muhardianab/STM32_Bluepill_Board/README.md

# STM32_Bluepill_Board
ReDesign STM32 Bluepill Board

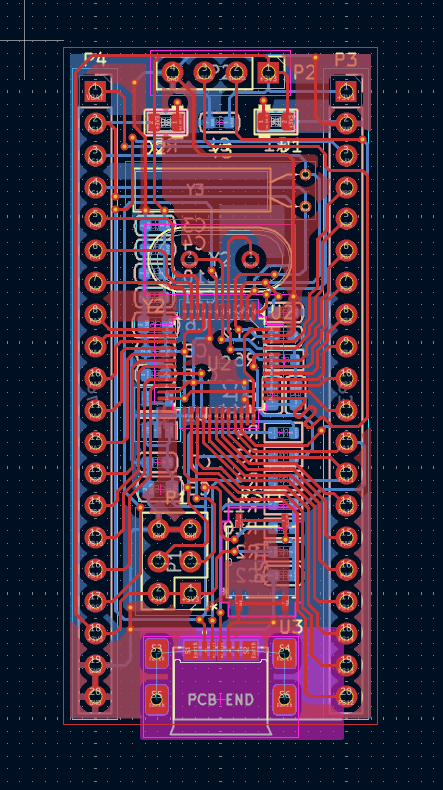
[picture p1: STM32_Bluepill_Kicad/board_layer_all.png]
PCB_preview


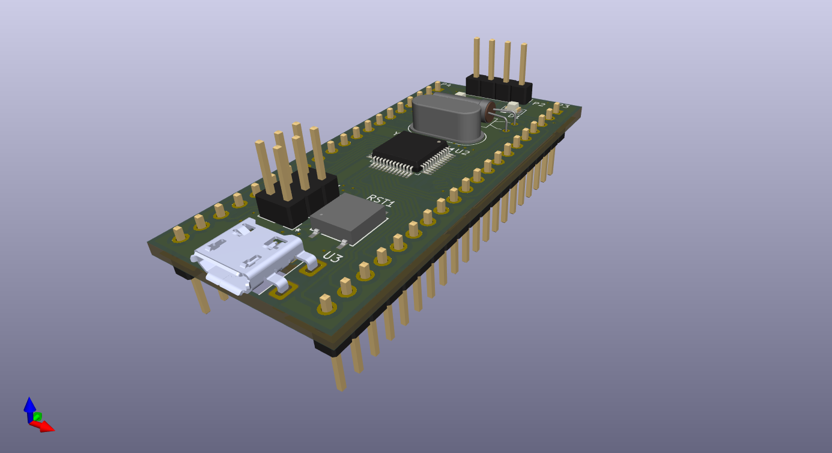
[picture p2: STM32_Bluepill_Kicad/SMT32_Bluepill_IsometricView.png]
Board


You can find the 3D file preview on [Grabcad](https://grabcad.com/library/stm32_bluepill-1)
