muhardianab/STM32_Bluepill_Board/STM32_Bluepill_Kicad/board_layer_top.png

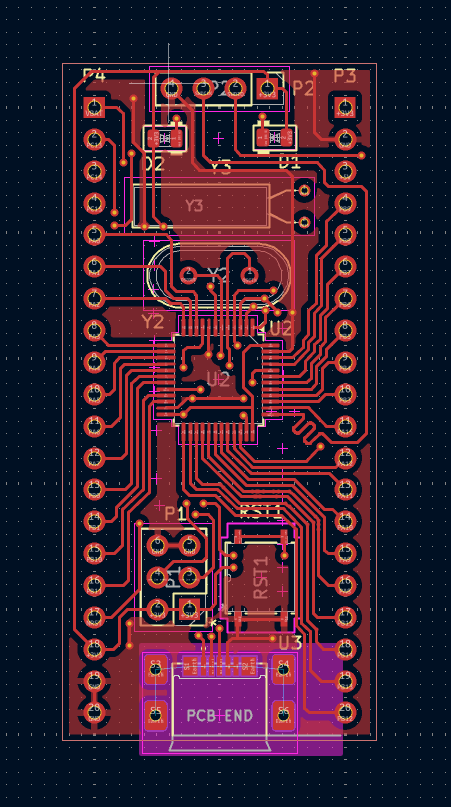
STM32_Bluepill_Kicad/board_layer_top.png
