muhardianab/STM32_Bluepill_Board/STM32_Bluepill_Kicad/SMT32_Bluepill_BottomView.png

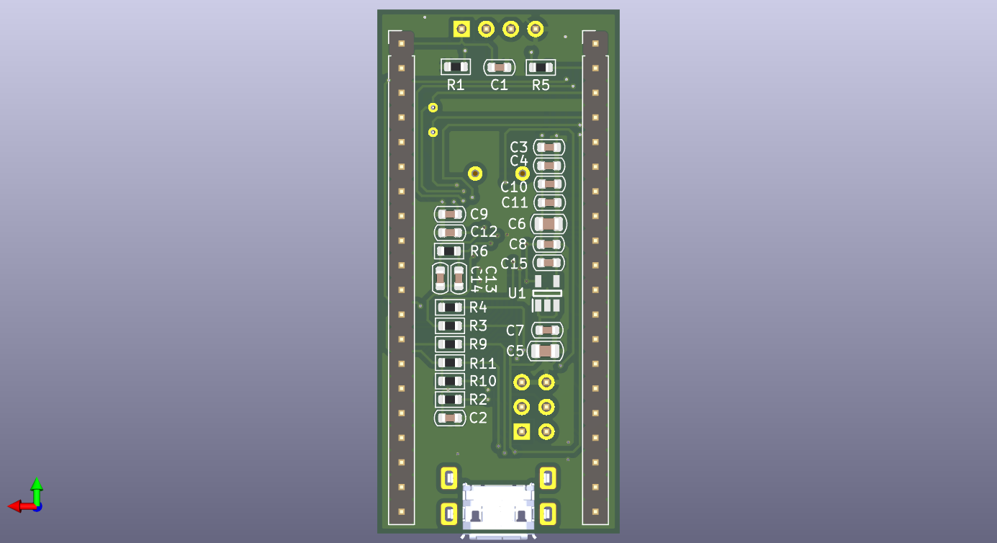
STM32_Bluepill_Kicad/SMT32_Bluepill_BottomView.png
