muhardianab/STM32_Bluepill_Board/STM32_Bluepill_Kicad/SMT32_Bluepill_IsometricBottomView.png

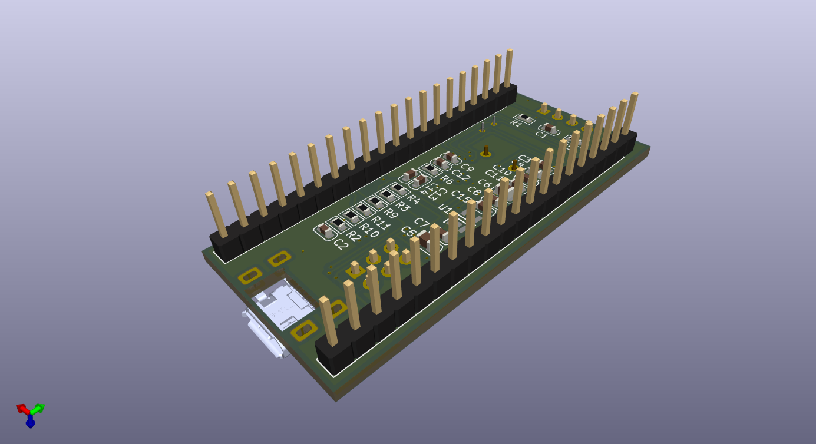
STM32_Bluepill_Kicad/SMT32_Bluepill_IsometricBottomView.png
