muhardianab/STM32_Bluepill_Board/STM32_Bluepill_Kicad/SMT32_Bluepill.step

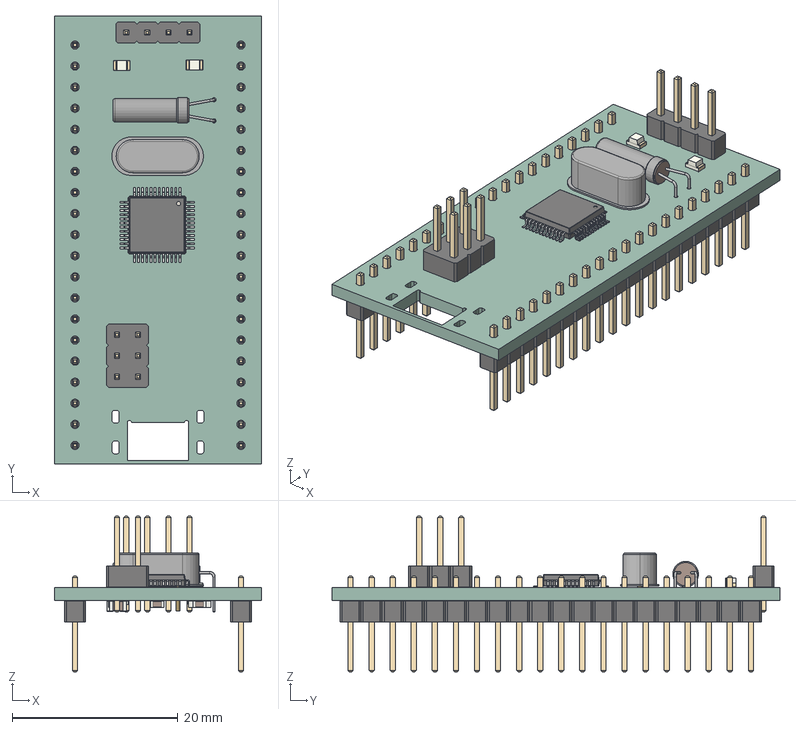
[picture p7: CAD file, 2025-02-28]
STM32_Bluepill_Kicad/SMT32_Bluepill.step
25.0 x 54.0 x 18.8 mm
LQFP-48_7x7mm_P0.5mm
LED_0805_2012Metric x 2
Crystal_AT310_D3.0mm_L10.0mm_Horizontal
Crystal_HC49-4H_Vertical
PinHeader_2x03_P2.54mm_Vertical
PinHeader_1x04_P2.54mm_Vertical
R_0603_1608Metric x 9
PinHeader_1x20_P2.54mm_Vertical x 2
C_0805_2012Metric x 2
C_0603_1608Metric x 13
SMT32_Bluepill_PCB
