muhardianab/STM32_Bluepill_Board/STM32_Bluepill_Kicad/SMT32_Bluepill.pdf

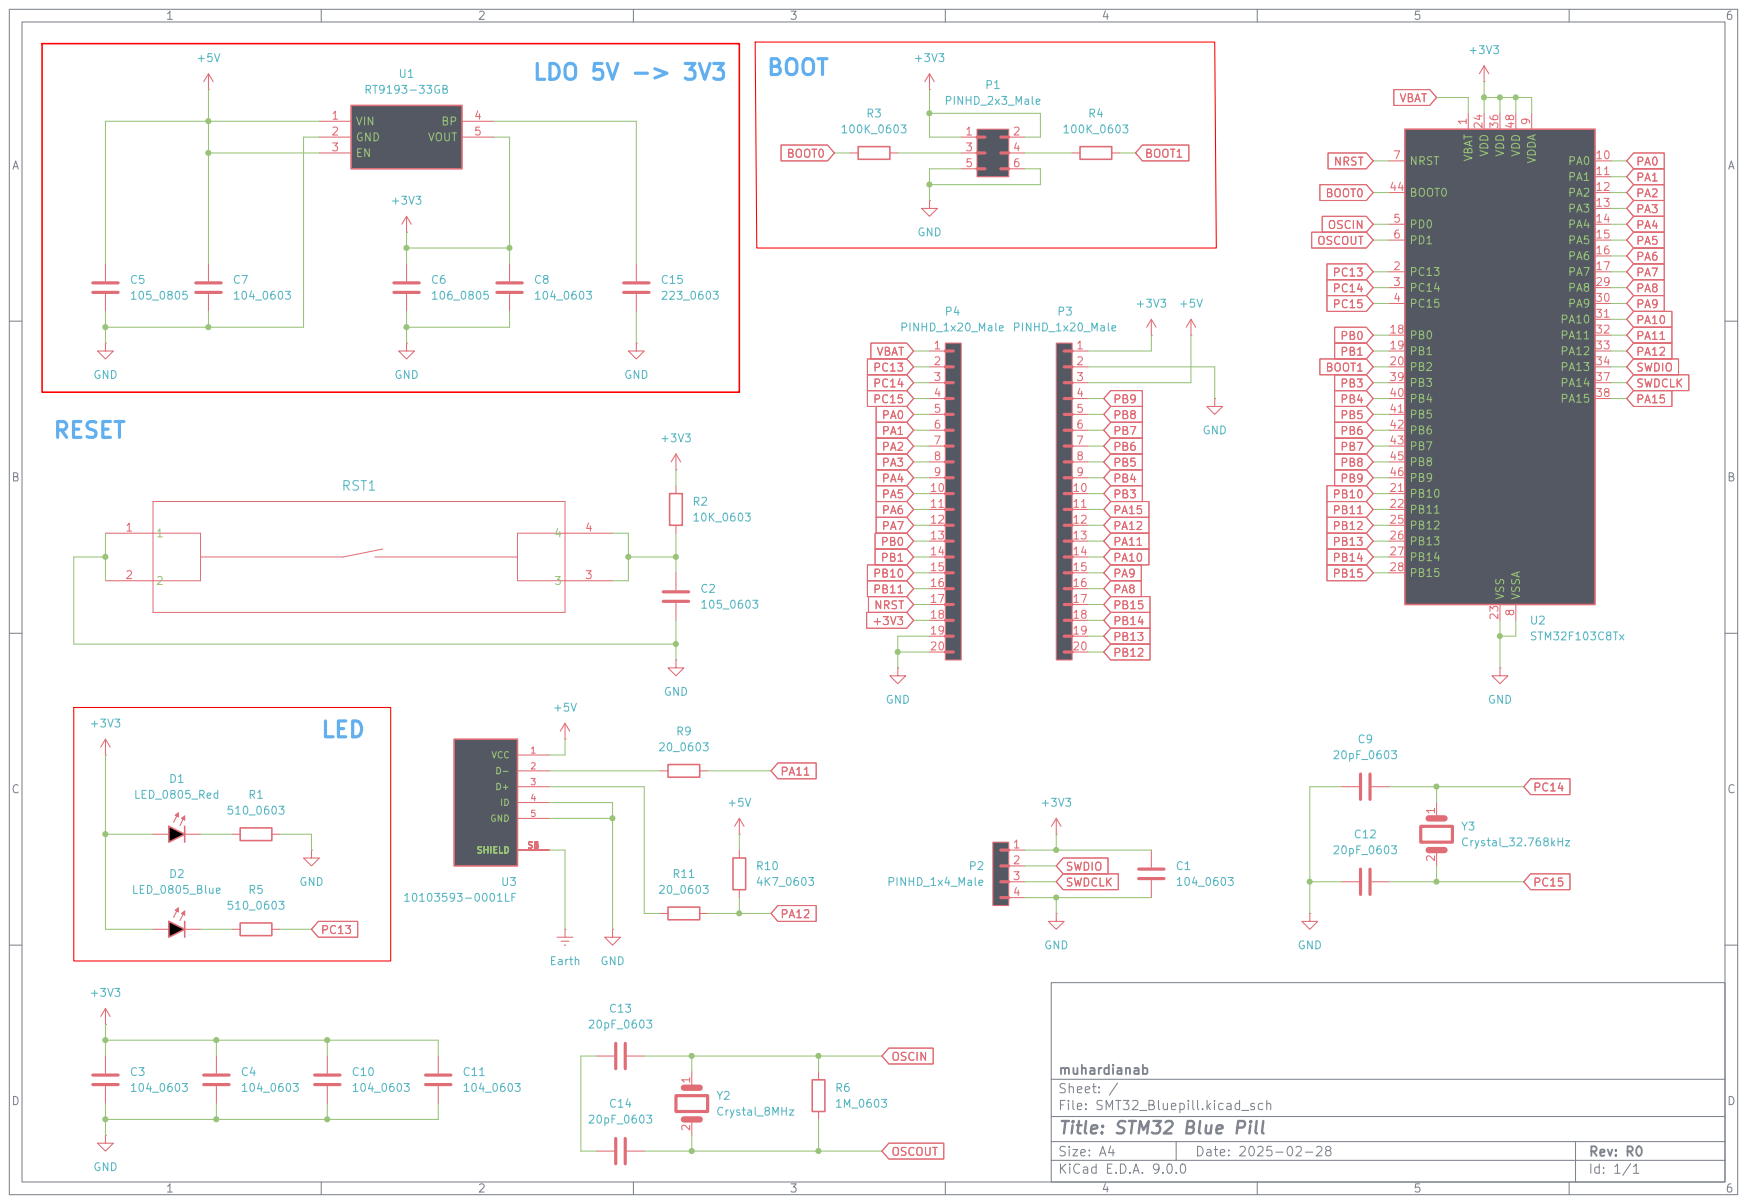
[picture p8: page 1]
