muhardianab/STM32_Bluepill_Board/STM32_Bluepill_Kicad/SMT32_Bluepill.kicad_pcb

## KiCad design STM32_Bluepill_Kicad/SMT32_Bluepill.kicad_pcb (2025-09-29)

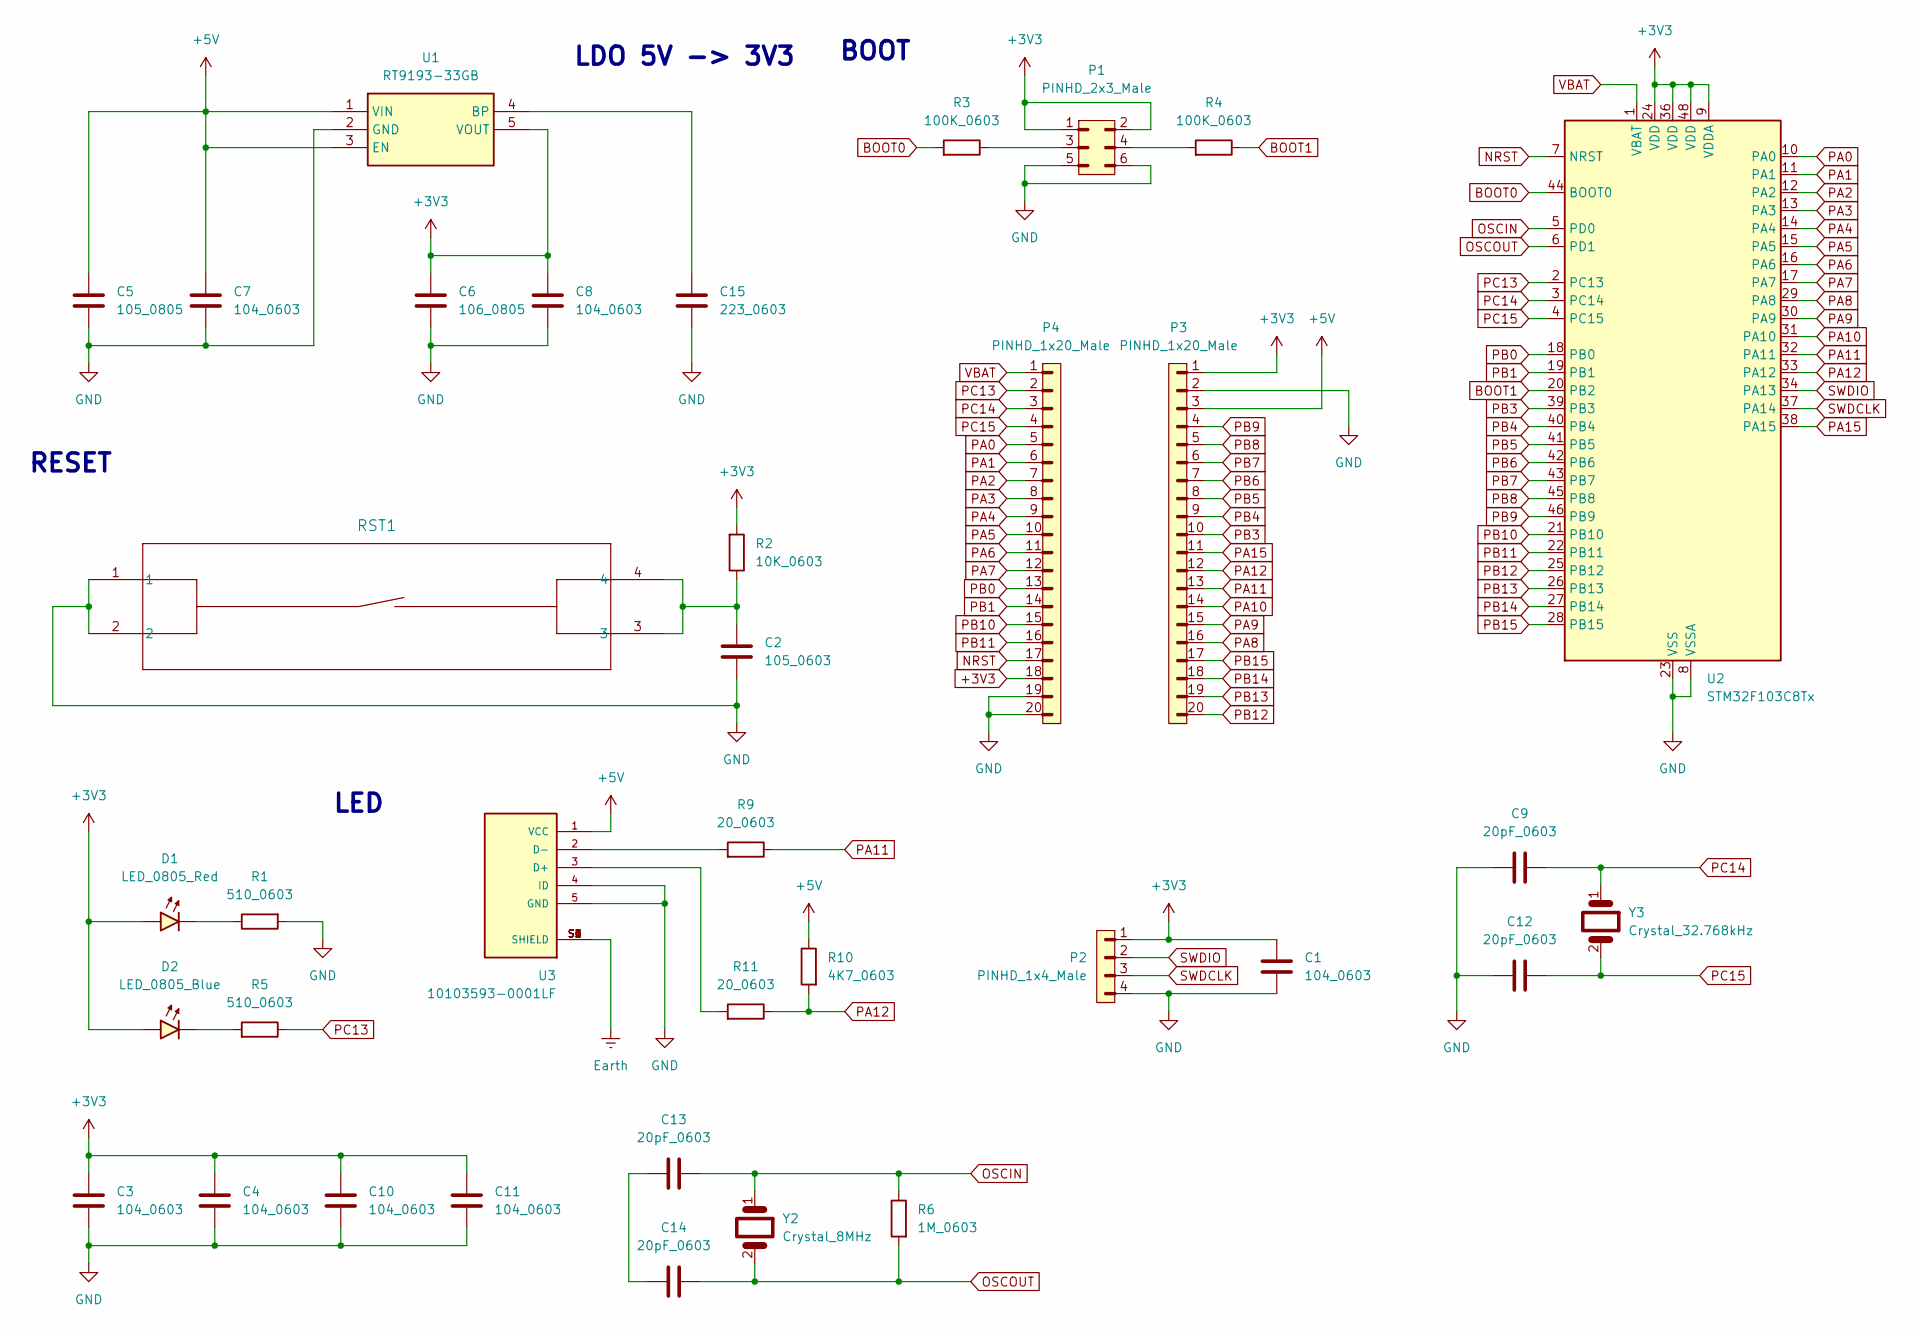
[picture p9: schematic SMT32_Bluepill.kicad_sch, STM32 Blue Pill]

Parts:
C1, C3, C4, C7, C8, C10, C11: 104_0603; C_0603_1608Metric
C2: 105_0603; C_0603_1608Metric
C5: 105_0805; C_0805_2012Metric
C6: 106_0805; C_0805_2012Metric
C9, C12, C13, C14: 20pF_0603; C_0603_1608Metric
C15: 223_0603; C_0603_1608Metric
D1: LED_0805_Red; LED_0805_2012Metric
D2: LED_0805_Blue; LED_0805_2012Metric
P1: PINHD_2x3_Male; PinHeader_2x03_P2.54mm_Vertical
P2: PINHD_1x4_Male; PinHeader_1x04_P2.54mm_Vertical
P3, P4: PINHD_1x20_Male; PinHeader_1x20_P2.54mm_Vertical
R1, R5: 510_0603; R_0603_1608Metric
R2: 10K_0603; R_0603_1608Metric
R3, R4: 100K_0603; R_0603_1608Metric
R6: 1M_0603; R_0603_1608Metric
R9, R11: 20_0603; R_0603_1608Metric
R10: 4K7_0603; R_0603_1608Metric
RST1: PTS526 SM15 SMTR2 LFS; SON4_PTS526 SM15 SMTR2 LFS_CNK-M
U1: RT9193-33GB; SOT94P279X130-5N; Mouser Part Number 835-RT9193-33GB
U2: STM32F103C8Tx; LQFP-48_7x7mm_P0.5mm
U3: 10103593-0001LF; AMPHENOL_10103593-0001LF; PARTREV A
Y2: Crystal_8MHz; Crystal_HC49-4H_Vertical
Y3: Crystal_32.768kHz; Crystal_AT310_D3.0mm_L10.0mm_Horizontal

Connections:
+3V3: C1.1, C3.1, C4.1, C6.1, C8.1, C10.1, C11.1, D1.2 (A), D2.2 (A), P1.1, P1.2, P2.1, P3.1, P4.18, R2.1, U1.5 (VOUT), U2.9 (VDDA), U2.24 (VDD), U2.36 (VDD), U2.48 (VDD)
+5V: C5.1, C7.1, P3.3, R10.2, U1.1 (VIN), U1.3 (EN), U3.1 (VCC)
BOOT0: R3.1, U2.44 (BOOT0)
BOOT1: R4.2, U2.20 (PB2)
Earth: U3.S1 (SHIELD), U3.S2 (SHIELD), U3.S3 (SHIELD), U3.S4 (SHIELD), U3.S5 (SHIELD), U3.S6 (SHIELD)
GND: C1.2, C2.2, C3.2, C4.2, C5.2, C6.2, C7.2, C8.2, C9.1, C10.2, C11.2, C12.1, C15.2, P1.5, P1.6, P2.4, P3.2, P4.19, P4.20, R1.1, RST1.1, RST1.2, U1.2 (GND), U2.8 (VSSA), U2.23 (VSS), U2.35 (VSS), U2.47 (VSS), U3.4 (ID), U3.5 (GND)
NRST: P4.17, U2.7 (NRST)
unnamed: C2.1, R2.2, RST1.3, RST1.4
unnamed: C13.1, C14.1
unnamed: D1.1 (K), R1.2
unnamed: D2.1 (K), R5.1
unnamed: P1.3, R3.2
unnamed: P1.4, R4.1
unnamed: C15.1, U1.4 (BP)
unnamed: R11.1, U3.3 (D+)
unnamed: R9.1, U3.2 (D-)
OSCIN: C13.2, R6.2, U2.5 (PD0), Y2.1
OSCOUT: C14.2, R6.1, U2.6 (PD1), Y2.2
PA0: P4.5, U2.10 (PA0)
PA1: P4.6, U2.11 (PA1)
PA2: P4.7, U2.12 (PA2)
PA3: P4.8, U2.13 (PA3)
PA4: P4.9, U2.14 (PA4)
PA5: P4.10, U2.15 (PA5)
PA6: P4.11, U2.16 (PA6)
PA7: P4.12, U2.17 (PA7)
PA8: P3.16, U2.29 (PA8)
PA9: P3.15, U2.30 (PA9)
PA10: P3.14, U2.31 (PA10)
PA11: P3.13, R9.2, U2.32 (PA11)
PA12: P3.12, R10.1, R11.2, U2.33 (PA12)
PA15: P3.11, U2.38 (PA15)
PB0: P4.13, U2.18 (PB0)
PB1: P4.14, U2.19 (PB1)
PB3: P3.10, U2.39 (PB3)
PB4: P3.9, U2.40 (PB4)
PB5: P3.8, U2.41 (PB5)
PB6: P3.7, U2.42 (PB6)
PB7: P3.6, U2.43 (PB7)
PB8: P3.5, U2.45 (PB8)
PB9: P3.4, U2.46 (PB9)
PB10: P4.15, U2.21 (PB10)
PB11: P4.16, U2.22 (PB11)
PB12: P3.20, U2.25 (PB12)
PB13: P3.19, U2.26 (PB13)
PB14: P3.18, U2.27 (PB14)
PB15: P3.17, U2.28 (PB15)
PC13: P4.2, R5.2, U2.2 (PC13)
PC14: C9.2, P4.3, U2.3 (PC14), Y3.1
PC15: C12.2, P4.4, U2.4 (PC15), Y3.2
SWDCLK: P2.3, U2.37 (PA14)
SWDIO: P2.2, U2.34 (PA13)
VBAT: P4.1, U2.1 (VBAT)

Notes on the sheet:
LED
LDO 5V -> 3V3
BOOT
RESET

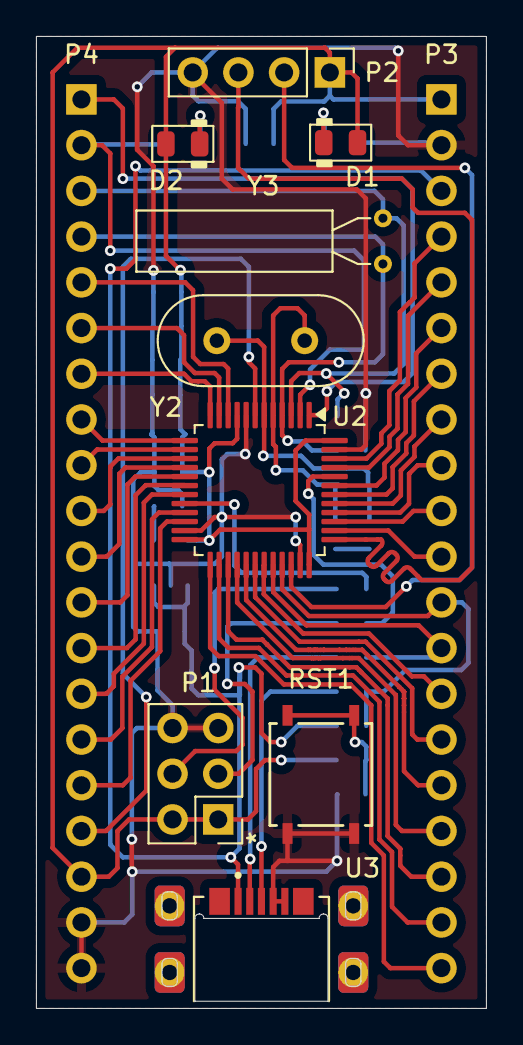
[picture p10: board SMT32_Bluepill.kicad_pcb from above]

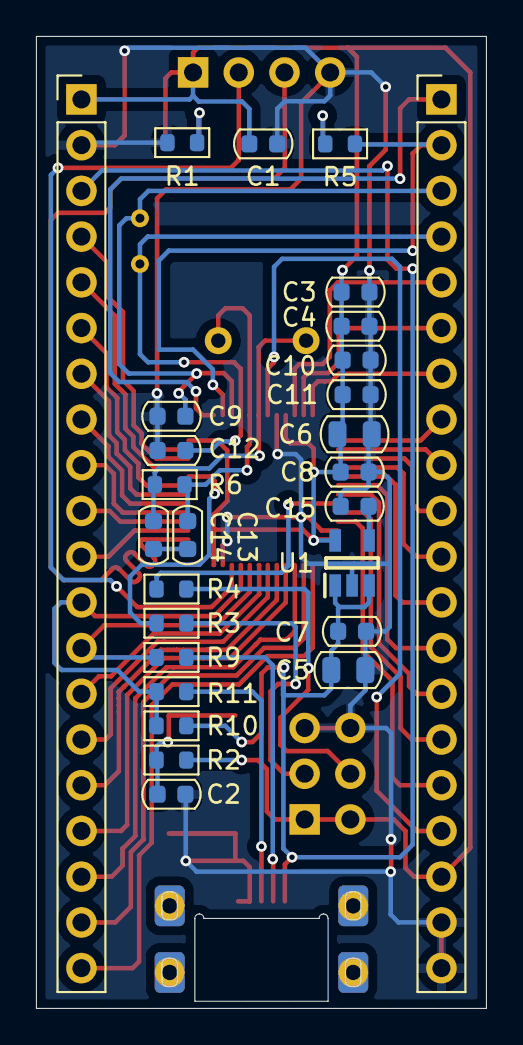
[picture p11: board SMT32_Bluepill.kicad_pcb from below]

Board: 2 copper layers, 25.0 x 54.0 mm, 36 parts (27 on the bottom side), 53 nets.
