muhardianab/STM32_Bluepill_Board/(commit log)

2025-02-25 First Upload
    [SMT32_Bluepill.kicad_pcb, SMT32_Bluepill.kicad_sch]
2025-02-25 Move folder
    [SMT32_Bluepill.kicad_pcb, SMT32_Bluepill.kicad_sch]
2025-02-25 Schematic done, PCB 50%
    Component placements still undone
    [SMT32_Bluepill.kicad_pcb, SMT32_Bluepill.kicad_sch]
2025-02-26 PCB 70%
    This version haven't been to redesign
    [SMT32_Bluepill.kicad_pcb, SMT32_Bluepill.kicad_sch]
2025-02-27 PCB 80%
    There are some traces that need to be retraced
    [SMT32_Bluepill.kicad_pcb, SMT32_Bluepill.kicad_sch]
2025-02-28 Final R0
    Done R0
    [SMT32_Bluepill-B_Courtyard.gbr, SMT32_Bluepill-B_Cu.gbr, SMT32_Bluepill-B_Fab.gbr, SMT32_Bluepill-B_Mask.gbr, SMT32_Bluepill-B_Paste.gbr, SMT32_Bluepill-B_Silkscreen.gbr, SMT32_Bluepill-Edge_Cuts.gbr, SMT32_Bluepill-F_Courtyard.gbr]
2025-09-29 Update board and preview
    Update the 3D components of the library and preview of the board
    [SMT32_Bluepill.kicad_pcb, SMT32_Bluepill.kicad_sch]
